carlystroll-lgtm/EXSU-620-Midterm-project-/verification/evidence/all_angle_attempts.csv

reference_deg | trial | attempt | selected | mean_deg | mean_error_deg | all_samples_within_5_deg | source
-90 | 1 | 1 | False | -84.14 | 5.859999999999999 | False | reference_minus90_20261107_173739.json
-90 | 1 | 2 | True | -91.45 | -1.4500000000000028 | True | reference_minus90_retry_20261107_173838.json
-90 | 2 | 1 | True | -85.93 | 4.069999999999993 | True | reference_minus90_trial2_20261107_174734.json
-90 | 3 | 1 | False | -80.81 | 9.189999999999998 | False | reference_minus90_trial3_20261107_175347.json
-90 | 3 | 2 | True | -87.91 | 2.0900000000000034 | True | reference_minus90_trial3_retry_20261107_175436.json
-60 | 1 | 1 | False | -66.94 | -6.939999999999998 | False | reference_minus60_20261107_173537.json
-60 | 1 | 2 | True | -58.34 | 1.6599999999999966 | True | reference_minus60_trial1_retry_20261108_082235.json
-60 | 2 | 1 | True | -63.47 | -3.469999999999999 | True | reference_minus60_trial2_20261107_174609.json
-60 | 3 | 1 | True | -55.77 | 4.229999999999997 | True | reference_minus60_trial3_20261107_175214.json
-30 | 1 | 1 | False | -47.23 | -17.229999999999997 | False | reference_minus30_20261107_172724.json
-30 | 1 | 2 | False | -50.13 | -20.130000000000003 | False | reference_minus30_retry_20261107_172914.json
-30 | 1 | 3 | False | -23.22 | 6.780000000000001 | False | reference_minus30_retry_20261107_173012.json
-30 | 1 | 4 | True | -32.69 | -2.6899999999999977 | True | reference_minus30_retry_20261107_173117.json
-30 | 2 | 1 | True | -31.04 | -1.0399999999999991 | True | reference_minus30_trial2_20261107_174334.json
-30 | 3 | 1 | True | -28.14 | 1.8599999999999994 | True | reference_minus30_trial3_20261107_175032.json
0 | 1 | 1 | True | 1.5 | 1.5 | True | reference_zero_trial1_late_20261108_082051.json
0 | 2 | 1 | True | 0.11 | 0.11 | True | reference_zero_trial2_20261107_173932.json
0 | 3 | 1 | True | -0.47 | -0.47 | True | reference_zero_trial3_20261107_174819.json
30 | 1 | 1 | False | -1.96 | -31.96 | False | reference_plus30_20261107_172407.json
30 | 1 | 2 | True | 29.75 | -0.25 | True | reference_plus30_retry_20261107_172621.json
30 | 2 | 1 | False | -26.82 | -56.82 | False | reference_plus30_trial2_20261107_174033.json
30 | 2 | 2 | True | 27.44 | -2.5599999999999987 | True | reference_plus30_trial2_retry_20261107_174219.json
30 | 3 | 1 | True | 32.87 | 2.8699999999999974 | True | reference_plus30_trial3_20261107_174945.json
60 | 1 | 1 | False | 34.18 | -25.82 | False | reference_plus60_20261107_173211.json
60 | 1 | 2 | False | 45.42 | -14.579999999999998 | False | reference_plus60_retry_20261107_173325.json
60 | 1 | 3 | True | 63.61 | 3.6099999999999994 | True | reference_plus60_retry_20261107_173409.json
60 | 2 | 1 | False | 66.16 | 6.159999999999997 | False | reference_plus60_trial2_20261107_174503.json
60 | 2 | 2 | True | 61.24 | 1.240000000000002 | True | reference_plus60_trial2_retry_20261108_082401.json
60 | 3 | 1 | True | 60.47 | 0.46999999999999886 | True | reference_plus60_trial3_20261107_175125.json
90 | 1 | 1 | True | 90.17 | 0.1700000000000017 | True | reference_plus90_20261107_173639.json
90 | 2 | 1 | True | 90.07 | 0.06999999999999318 | True | reference_plus90_trial2_20261107_174652.json
90 | 3 | 1 | True | 92.05 | 2.049999999999997 | True | reference_plus90_trial3_20261107_175303.json
