carlystroll-lgtm/EXSU-620-Midterm-project-/enclosure/bedside_box_lid.stl

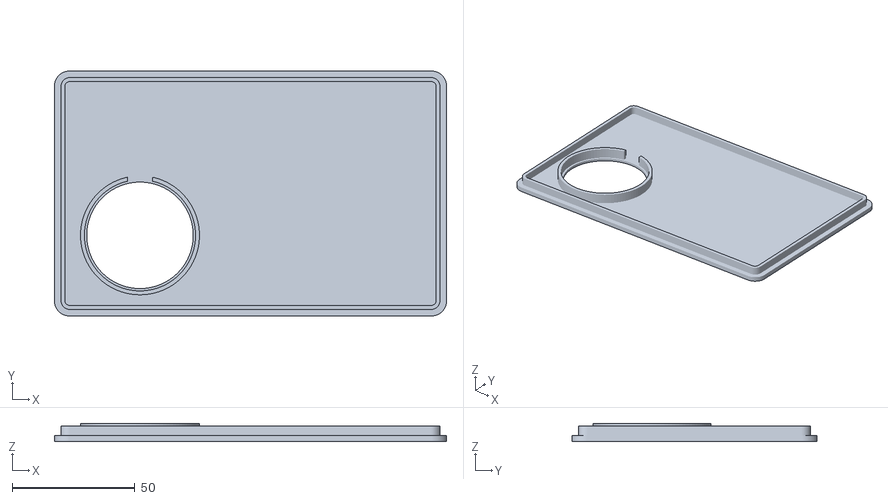
[picture p1: CAD file, 2026-11-09]
enclosure/bedside_box_lid.stl
159.8 x 99.8 x 7.40
