carlystroll-lgtm/EXSU-620-Midterm-project-/enclosure/body_cradle.stl

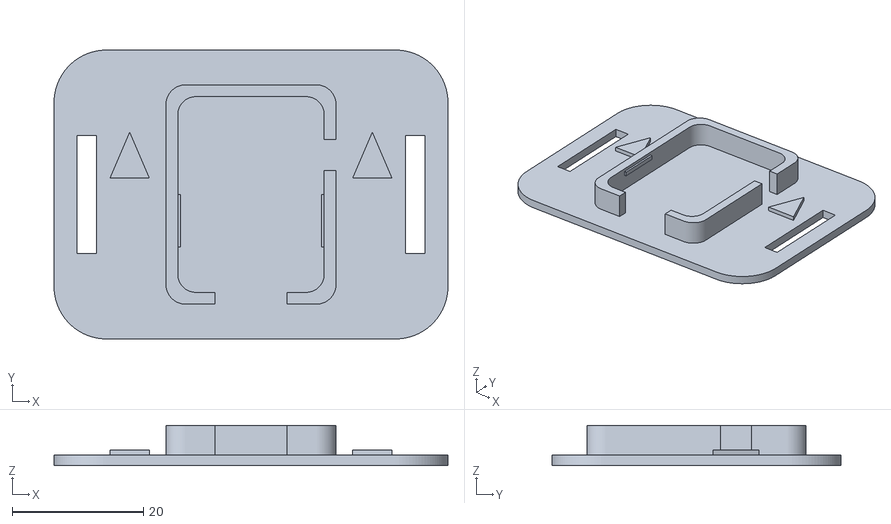
[picture p2: CAD file, 2026-11-09]
enclosure/body_cradle.stl
60.0 x 44.0 x 6.10
