carlystroll-lgtm/EXSU-620-Midterm-project-/enclosure/light_diffuser.stl

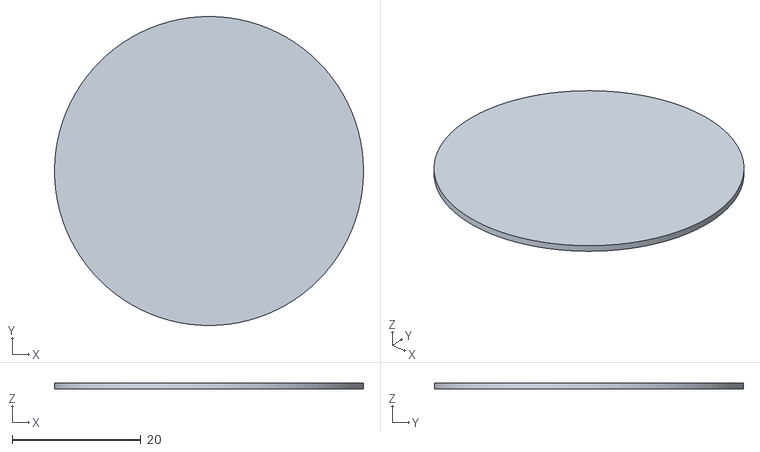
[picture p3: CAD file, 2026-11-09]
enclosure/light_diffuser.stl
48.0 x 48.0 x 1.00
