carlystroll-lgtm/EXSU-620-Midterm-project-/enclosure/jig_cradle.stl

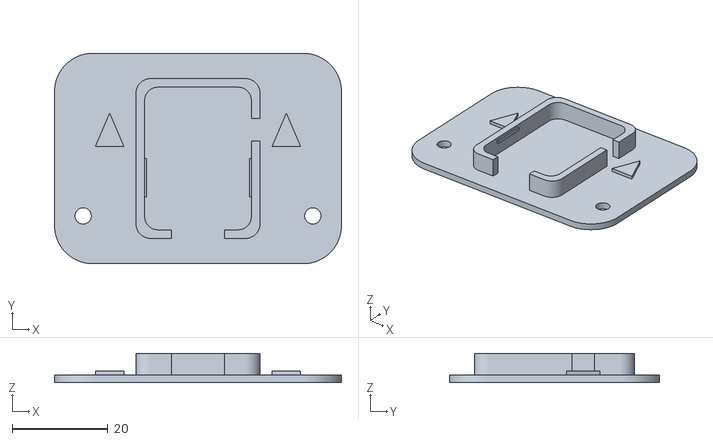
[picture p4: CAD file, 2026-11-09]
enclosure/jig_cradle.stl
60.0 x 44.0 x 6.10
