carlystroll-lgtm/EXSU-620-Midterm-project-/enclosure/sensor_pod.stl

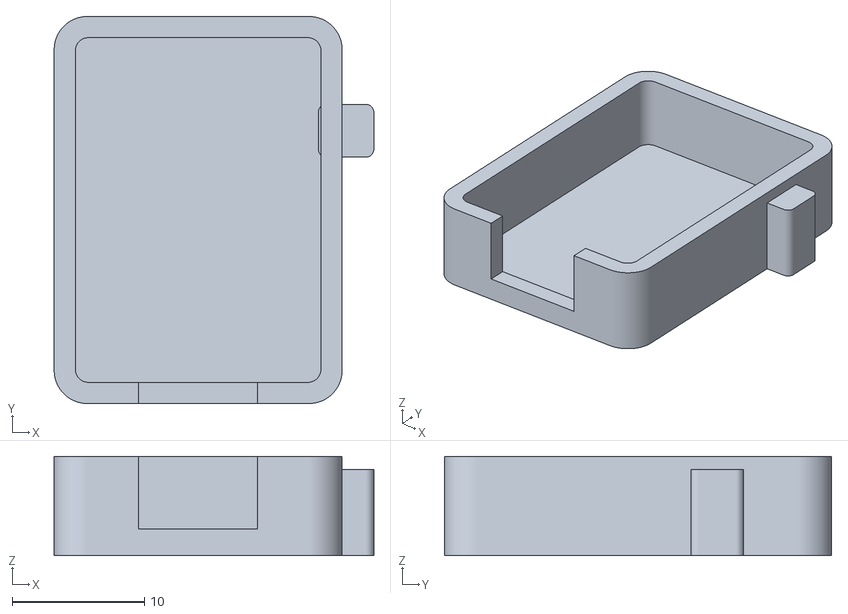
[picture p5: CAD file, 2026-11-09]
enclosure/sensor_pod.stl
24.2 x 29.3 x 7.50
