carlystroll-lgtm/EXSU-620-Midterm-project-/enclosure/sensor_pod_cap.stl

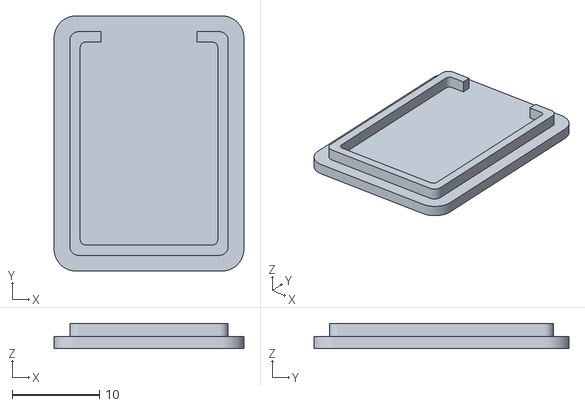
[picture p6: CAD file, 2026-11-09]
enclosure/sensor_pod_cap.stl
21.8 x 29.3 x 2.90
