carlystroll-lgtm/EXSU-620-Midterm-project-/enclosure/bedside_box_base.stl

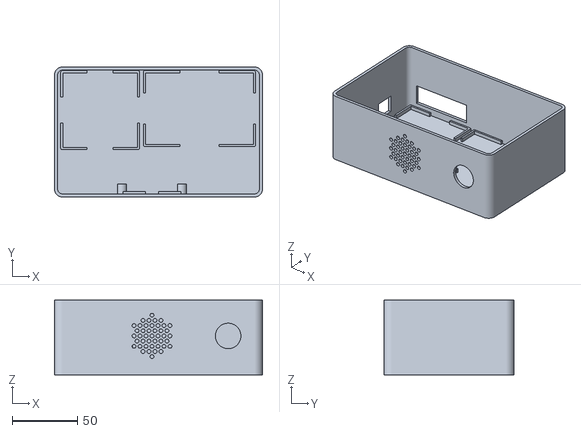
[picture p7: CAD file, 2026-11-09]
enclosure/bedside_box_base.stl
159.8 x 99.8 x 57.4
