carlystroll-lgtm/EXSU-620-Midterm-project-/verification/evidence/reviews/v4_patch_measurements.md

# V4: assembled patch geometry (ER-3)

Date: 9 November 2026  
Operator: Kyri Williams  
Item: assembled sensor patch (pod in body cradle), cable excluded

## Size (calipers, length × width × height)

| Repeat | Length (mm) | Width (mm) | Height (mm) |
|---|---|---|---|
| 1 | 59.2 | 43.1 | 11.6 |
| 2 | 59.2 | 42.9 | 11.6 |
| 3 | 59.1 | 42.7 | 11.5 |

Limits: footprint ≤ 60 × 45 mm, height ≤ 12 mm. All three repeats within limits.

## Outer corner radius

Measured 8.4 mm. Limit ≥ 2 mm. Within limit.

## Reverse seating

Ten attempts to seat the pod rotated 180° in its holder: 10/10 could not seat fully (rejected). Requirement: only one seating orientation. Met.

## Mass

Not measured (no scale with 0.1 g resolution available). Limit ≤ 25 g excluding cable. Open.

## Verdict

ER-3 PARTIAL: size, corner radius and reverse seating met; mass not measured.
