carlystroll-lgtm/EXSU-620-Midterm-project-/verification/evidence/protocol_1615_schedule_comparison.csv

step | planned_label | planned_position | planned_start_s | planned_end_s | provisional_video_start_s | provisional_video_end_s | video_review | angle_or_dwell_independently_confirmed | recorded_turn_events_in_provisional_window | diagnostic_comparison | event_video_relative_s | excluded_from_performance_scoring | exclusion_basis
1 | partial | supine | 30.0 | 56.0 | 34.0 | 60.0 | Hand-held tilt and reference instrument visible; angle markings or baseline not continuously readable. | False | 0 | no turn event |  | False
2 | partial | supine | 61.0 | 87.0 | 65.0 | 91.0 | Hand-held tilt and reference instrument visible; angle markings or baseline not continuously readable. | False | 0 | no turn event |  | False
3 | turn | right | 92.0 | 126.0 | 96.0 | 130.0 | Tilted sensor and protractor visible, but angle scale/zero not reliably readable; no turn event. | False | 0 | no event |  | True | Operator-reported interrupted hold
4 | turn | supine | 126.0 | 160.0 | 130.0 | 164.0 | Sensor visibly rests flat in inspected views; no turn event. Prior effective-turn premise not established. | False | 0 | no event |  | True | Dependent return after preceding qualifying turn not established
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
