carlystroll-lgtm/EXSU-620-Midterm-project-/verification/README.md

# Verification evidence

This folder preserves the supplied November 7–8, 2026 verification package separately from the prototype source code.

- [Verification report](EXSU620_Project08_Verification_Report.md)
- [Supporting evidence](evidence/README.md): measurements, raw records, review notes and figures.
- `pdf/`: supplied PDF report.
- [Original Google Drive folder](https://drive.google.com/drive/folders/1WikbcNspue474xlvEYO-r4P4Dek5vPGW)

Results and limitations are retained as supplied. This package is evidence, not a copy of the deployed firmware or phone-alert service. Original videos are not included in the supplied package. Some working-review links refer to the original test environment.
