carlystroll-lgtm/EXSU-620-Midterm-project-/verification/evidence/reviews/roll_accuracy_results.md

# Roll accuracy — selected results

The main table uses the latest captured attempt for each angle/trial. Repeats are explicitly identified. Earlier attempts remain in the appendix and raw evidence; selection does not invalidate them or establish an overall pass. Reference angles were operator stated and were not visually confirmed. Calibration was unchanged during these captures.

| Reference (°) | Trial | Mean roll (°) | Mean error (°) | All captured samples within ±5° | Attempt | Evidence |
|---|---|---|---|---|---|---|
| -90 | 1 | -91.45 | -1.45 | Yes | Repeat (attempt 2 of 2) | [reference_minus90_retry_20261107_173838.json](reference_minus90_retry_20261107_173838.json) |
| -90 | 2 | -85.93 | +4.07 | Yes | Initial captured attempt | [reference_minus90_trial2_20261107_174734.json](reference_minus90_trial2_20261107_174734.json) |
| -90 | 3 | -87.91 | +2.09 | Yes | Repeat (attempt 2 of 2) | [reference_minus90_trial3_retry_20261107_175436.json](reference_minus90_trial3_retry_20261107_175436.json) |
| -60 | 1 | -58.34 | +1.66 | Yes | Later repeat; original retained | [reference_minus60_trial1_retry_20261108_082235.json](reference_minus60_trial1_retry_20261108_082235.json) |
| -60 | 2 | -63.47 | -3.47 | Yes | Initial captured attempt | [reference_minus60_trial2_20261107_174609.json](reference_minus60_trial2_20261107_174609.json) |
| -60 | 3 | -55.77 | +4.23 | Yes | Initial captured attempt | [reference_minus60_trial3_20261107_175214.json](reference_minus60_trial3_20261107_175214.json) |
| -30 | 1 | -32.69 | -2.69 | Yes | Repeat (attempt 4 of 4) | [reference_minus30_retry_20261107_173117.json](reference_minus30_retry_20261107_173117.json) |
| -30 | 2 | -31.04 | -1.04 | Yes | Initial captured attempt | [reference_minus30_trial2_20261107_174334.json](reference_minus30_trial2_20261107_174334.json) |
| -30 | 3 | -28.14 | +1.86 | Yes | Initial captured attempt | [reference_minus30_trial3_20261107_175032.json](reference_minus30_trial3_20261107_175032.json) |
| +0 | 1 | 1.50 | +1.50 | Yes | Independent trial collected later; not backdated | [reference_zero_trial1_late_20261108_082051.json](reference_zero_trial1_late_20261108_082051.json) |
| +0 | 2 | 0.11 | +0.11 | Yes | Initial captured attempt | [reference_zero_trial2_20261107_173932.json](reference_zero_trial2_20261107_173932.json) |
| +0 | 3 | -0.47 | -0.47 | Yes | Initial captured attempt | [reference_zero_trial3_20261107_174819.json](reference_zero_trial3_20261107_174819.json) |
| +30 | 1 | 29.75 | -0.25 | Yes | Repeat (attempt 2 of 2) | [reference_plus30_retry_20261107_172621.json](reference_plus30_retry_20261107_172621.json) |
| +30 | 2 | 27.44 | -2.56 | Yes | Repeat (attempt 2 of 2) | [reference_plus30_trial2_retry_20261107_174219.json](reference_plus30_trial2_retry_20261107_174219.json) |
| +30 | 3 | 32.87 | +2.87 | Yes | Initial captured attempt | [reference_plus30_trial3_20261107_174945.json](reference_plus30_trial3_20261107_174945.json) |
| +60 | 1 | 63.61 | +3.61 | Yes | Repeat (attempt 3 of 3) | [reference_plus60_retry_20261107_173409.json](reference_plus60_retry_20261107_173409.json) |
| +60 | 2 | 61.24 | +1.24 | Yes | Later repeat; original retained | [reference_plus60_trial2_retry_20261108_082401.json](reference_plus60_trial2_retry_20261108_082401.json) |
| +60 | 3 | 60.47 | +0.47 | Yes | Initial captured attempt | [reference_plus60_trial3_20261107_175125.json](reference_plus60_trial3_20261107_175125.json) |
| +90 | 1 | 90.17 | +0.17 | Yes | Initial captured attempt | [reference_plus90_20261107_173639.json](reference_plus90_20261107_173639.json) |
| +90 | 2 | 90.07 | +0.07 | Yes | Initial captured attempt | [reference_plus90_trial2_20261107_174652.json](reference_plus90_trial2_20261107_174652.json) |
| +90 | 3 | 92.05 | +2.05 | Yes | Initial captured attempt | [reference_plus90_trial3_20261107_175303.json](reference_plus90_trial3_20261107_175303.json) |

## Interpretation

These are repeated samples at each held position, not ten independent repositioning trials. The missing independent 0° trial was subsequently collected on November 8, after repositioning, with +1.50° mean roll. It is identified as a later capture; the original post-correction zero check remains calibration evidence.

An overall accuracy pass has not been established. The latest −60° trial 1 repeat is within tolerance (+1.66° error); its earlier −6.94° error remains in the evidence and its cause is unresolved. The later +60° trial 2 repeat is also within tolerance (+1.24° error). Every latest selected angle/trial capture is now within tolerance, but earlier out-of-tolerance attempts remain part of the evidence; the cause of those discrepancies has not been established. An exclusion requires a documented setup error, not merely an improved repeat result.

## Appendix — all captured attempts

| Reference (°) | Trial | Capture | Mean roll (°) | Mean error (°) | Within ±5° for all samples |
|---|---|---|---|---|---|
| -30 | 1 | [reference_minus30_20261107_172724.json](reference_minus30_20261107_172724.json) | -47.23 | -17.23 | No |
| -30 | 1 | [reference_minus30_retry_20261107_172914.json](reference_minus30_retry_20261107_172914.json) | -50.13 | -20.13 | No |
| -30 | 1 | [reference_minus30_retry_20261107_173012.json](reference_minus30_retry_20261107_173012.json) | -23.22 | +6.78 | No |
| -30 | 1 | [reference_minus30_retry_20261107_173117.json](reference_minus30_retry_20261107_173117.json) | -32.69 | -2.69 | Yes |
| -30 | 2 | [reference_minus30_trial2_20261107_174334.json](reference_minus30_trial2_20261107_174334.json) | -31.04 | -1.04 | Yes |
| -30 | 3 | [reference_minus30_trial3_20261107_175032.json](reference_minus30_trial3_20261107_175032.json) | -28.14 | +1.86 | Yes |
| -60 | 1 | [reference_minus60_20261107_173537.json](reference_minus60_20261107_173537.json) | -66.94 | -6.94 | No |
| -60 | 2 | [reference_minus60_trial2_20261107_174609.json](reference_minus60_trial2_20261107_174609.json) | -63.47 | -3.47 | Yes |
| -60 | 3 | [reference_minus60_trial3_20261107_175214.json](reference_minus60_trial3_20261107_175214.json) | -55.77 | +4.23 | Yes |
| -90 | 1 | [reference_minus90_20261107_173739.json](reference_minus90_20261107_173739.json) | -84.14 | +5.86 | No |
| -90 | 1 | [reference_minus90_retry_20261107_173838.json](reference_minus90_retry_20261107_173838.json) | -91.45 | -1.45 | Yes |
| -90 | 2 | [reference_minus90_trial2_20261107_174734.json](reference_minus90_trial2_20261107_174734.json) | -85.93 | +4.07 | Yes |
| -90 | 3 | [reference_minus90_trial3_20261107_175347.json](reference_minus90_trial3_20261107_175347.json) | -80.81 | +9.19 | No |
| -90 | 3 | [reference_minus90_trial3_retry_20261107_175436.json](reference_minus90_trial3_retry_20261107_175436.json) | -87.91 | +2.09 | Yes |
| +30 | 1 | [reference_plus30_20261107_172407.json](reference_plus30_20261107_172407.json) | -1.96 | -31.96 | No |
| +30 | 1 | [reference_plus30_retry_20261107_172621.json](reference_plus30_retry_20261107_172621.json) | 29.75 | -0.25 | Yes |
| +30 | 2 | [reference_plus30_trial2_20261107_174033.json](reference_plus30_trial2_20261107_174033.json) | -26.82 | -56.82 | No |
| +30 | 2 | [reference_plus30_trial2_retry_20261107_174219.json](reference_plus30_trial2_retry_20261107_174219.json) | 27.44 | -2.56 | Yes |
| +30 | 3 | [reference_plus30_trial3_20261107_174945.json](reference_plus30_trial3_20261107_174945.json) | 32.87 | +2.87 | Yes |
| +60 | 1 | [reference_plus60_20261107_173211.json](reference_plus60_20261107_173211.json) | 34.18 | -25.82 | No |
| +60 | 1 | [reference_plus60_retry_20261107_173325.json](reference_plus60_retry_20261107_173325.json) | 45.42 | -14.58 | No |
| +60 | 1 | [reference_plus60_retry_20261107_173409.json](reference_plus60_retry_20261107_173409.json) | 63.61 | +3.61 | Yes |
| +60 | 2 | [reference_plus60_trial2_20261107_174503.json](reference_plus60_trial2_20261107_174503.json) | 66.16 | +6.16 | No |
| +60 | 3 | [reference_plus60_trial3_20261107_175125.json](reference_plus60_trial3_20261107_175125.json) | 60.47 | +0.47 | Yes |
| +90 | 1 | [reference_plus90_20261107_173639.json](reference_plus90_20261107_173639.json) | 90.17 | +0.17 | Yes |
| +90 | 2 | [reference_plus90_trial2_20261107_174652.json](reference_plus90_trial2_20261107_174652.json) | 90.07 | +0.07 | Yes |
| +90 | 3 | [reference_plus90_trial3_20261107_175303.json](reference_plus90_trial3_20261107_175303.json) | 92.05 | +2.05 | Yes |
| +0 | 2 | [reference_zero_trial2_20261107_173932.json](reference_zero_trial2_20261107_173932.json) | 0.11 | +0.11 | Yes |
| +0 | 3 | [reference_zero_trial3_20261107_174819.json](reference_zero_trial3_20261107_174819.json) | -0.47 | -0.47 | Yes |
| +0 | 1 | [reference_zero_trial1_late_20261108_082051.json](reference_zero_trial1_late_20261108_082051.json) — later independent capture | 1.50 | +1.50 | Yes |
| -60 | 1 | [reference_minus60_trial1_retry_20261108_082235.json](reference_minus60_trial1_retry_20261108_082235.json) — later repeat | -58.34 | +1.66 | Yes |
| +60 | 2 | [reference_plus60_trial2_retry_20261108_082401.json](reference_plus60_trial2_retry_20261108_082401.json) — later repeat | 61.24 | +1.24 | Yes |
