carlystroll-lgtm/EXSU-620-Midterm-project-/analysis/calibration_template.csv

true_deg | trial | measured_deg
-90 | 1
-90 | 2
-90 | 3
-60 | 1
-60 | 2
-60 | 3
-30 | 1
-30 | 2
-30 | 3
0 | 1
0 | 2
0 | 3
30 | 1
30 | 2
30 | 3
60 | 1
60 | 2
60 | 3
90 | 1
90 | 2
90 | 3
