carlystroll-lgtm/EXSU-620-Midterm-project-/verification/evidence/figures/video_1623_contact.jpg

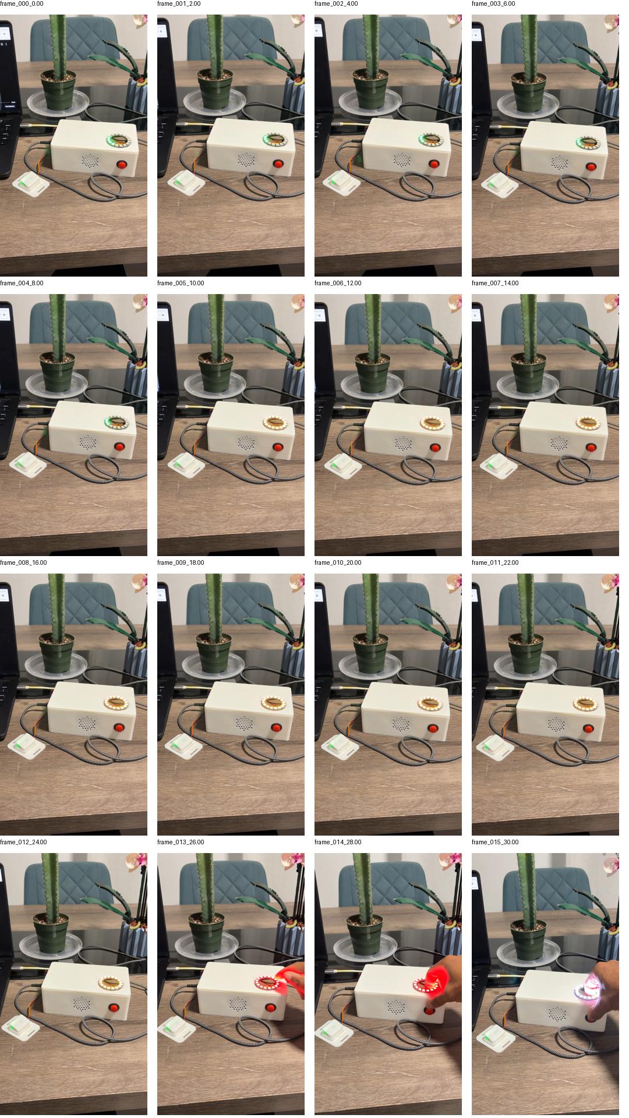
verification/evidence/figures/video_1623_contact.jpg
