carlystroll-lgtm/EXSU-620-Midterm-project-/(commit log)

2026-11-09 Add prototype code and documentation
    [bedside_box_base.stl, bedside_box_lid.stl, body_cradle.stl, calibration_template.csv, faults_template.csv, jig_cradle.stl, light_diffuser.stl, protocol_truth_template.csv]
2026-11-09 Add verification report and supporting evidence in separate folder
    [all_angle_attempts.csv, protocol_1615_schedule_comparison.csv, selected_angle_measurements.csv]
2026-11-09 Add V4 assembled patch measurements
2026-11-09 Add tested Telegram build for Nov 7–8 verification
2026-11-10 Update LSM6DS3TR-C sensor wiring instructions
    Removed the mention of extending the LSM6DS3TR-C sensor cable to about 1 m.
